BastaMasta/LumioV2_Hardware/Hardware/LumioV2-board-3d.png

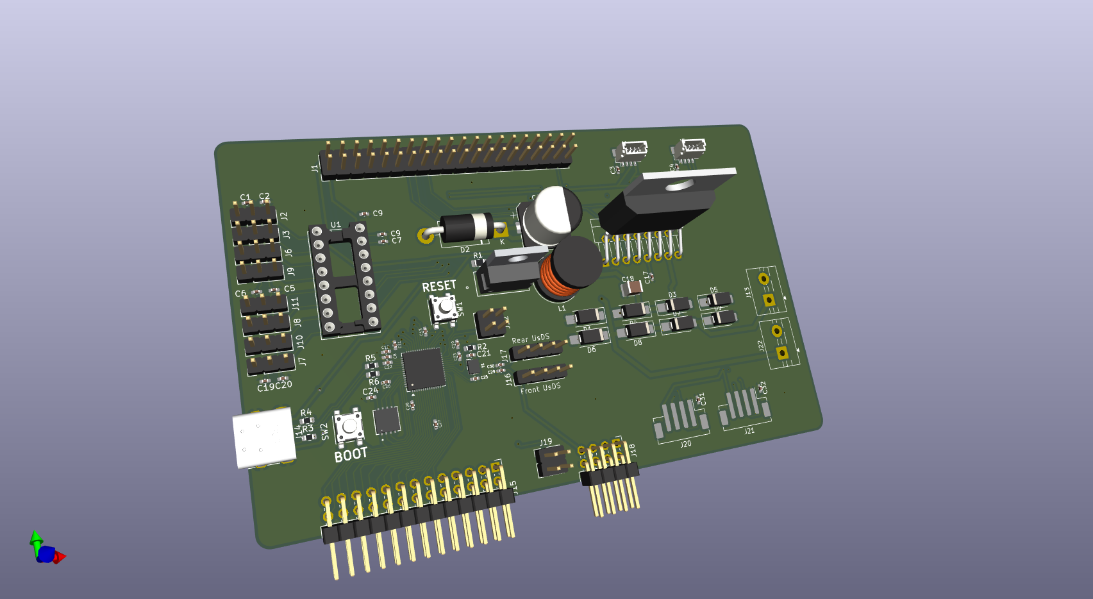
Hardware/LumioV2-board-3d.png
