BastaMasta/LumioV2_Hardware/README.md

# Lumio V2 Hardware

A repo containing all the hardware (shematic and PCB) files for the Lumio V2 Main Board
