BastaMasta/LumioV2_Hardware/Docs/SonyTech_Internship_FieldReport_TVA.pptx

🤖

INTERNSHIP REPORT

An 8-month internship report with SonyTech IT Company

Internship Field Report

Sameed Ahmed · 2VX22CB043

SonyTech IT Company · Aug 2025 – Apr 2026

VTU, Belagavi · CSE & Business Systems

## Slide 2

OVERVIEW

Internship At a Glance

35

Weeks

Aug 2025 – Apr 2026

5

PCB Revisions

V1 → Definitive V2

40+

Test Cases

All passing at close-out

4

Control Pathways

Sheets · IR · BT · WiFi

Project Timeline

Prototype
& Firmware

Onboarding
& EduTrack

PCB V1–V5
Design Arc

Lumio V2
Clean-Sheet

Handover
& Remote

Aug '25 Apr '26

## Slide 3

ORGANIZATION

SonyTech IT Company

SonyTech IT Company

Technology solutions firm specialising in software engineering, embedded systems, and educational technology.
Industry Mentor: Mr. Pranay M Mahendrakar
Location: Bengaluru, Karnataka

R.A.D.G.T.F Foundation

Educational non-profit commissioning the Lumio platform. Focused on innovative tools for classroom learning.
Defined requirements, reviewed prototypes, and guided technical priorities with emphasis on student engagement, safety, and classroom ease-of-deployment.

Academic Context Visvesvaraya Technological University, Belagavi · B.Tech CSE & Business Systems · 2025–2026 · Faculty Mentor: Mr. Rohit B Kaliwal

## Slide 4

THE PROJECT

What is Lumio?

An intelligent, open-hardware educational classroom robot — built from first principles.

Hardware

Custom 4-layer PCB (Lumio V2) with RP2040 co-processor, L298N motor driver, MCP3008 ADC, LM2577 boost converter, and full sensor array.

🔌

Firmware

HAL-abstracted multi-threaded Python stack — four concurrent control pathways, queue-arbitrated motor executor, display pipeline.

⚙️

On-Device AI

Vosk STT wake-word detection + Ollama (phi3:mini) LLM inference + Piper TTS — fully offline, no cloud dependency.

🧠

Google Sheets

Q&A engine and student progress reporting backend — teachers interact through a familiar spreadsheet interface.

📊

## Slide 5

HARDWARE

System Architecture

Lumio V2 PCB
4-layer, 115×73mm

Raspberry Pi 5
Primary Compute

DSI Display
Visual Output

40-pin ribbon

UART Interface

DSI Cable

Debug Power interface

RP2040
Co-Processor

DFRobot UPS
Battery-Backed

Pi Camera
(AI Vision — WIP)

L298N + SS34B
Motor Driver

MCP3008 SPI ADC
8-Channel Sensors

LM2577 Boost
5V → 12V Rail

## Slide 6

PCB DESIGN

PCB Journey: V1 → Definitive V2

V1

Pi Zero 2W
Chassis

Jumper-cable
prototype

V2–V5

CM5 Carrier
Exploration

Iterative
hardware arc

V2
Final

RPi 5 Platform
Clean-Sheet

DRC-clean
PCBA-ready

→

→

Key Design Decisions in Definitive V2

MCP3008 SPI ADC (8-ch) replacing ADS1115 — simpler sensor routing

SS34B Schottky freewheel diodes replacing 1N4148 — correct PWM flyback behaviour

LM2577 boost (5V→12V) with Vout = 1.23 × (1+R1/R2) design-from-equation

RP2040 (QFN-56) with W25Q64 SPI flash, 12MHz crystal, USB-C programming port

DSI display replacing I2C HAT — native RPi firmware framebuffer, no custom driver

Custom KiCad RPi 5 40-pin ribbon header symbol (Conn_02x20_Odd_Even)

## Slide 7

FIRMWARE

Firmware Architecture

Two-layer design: HAL (hardware abstraction) + RobotController (zero GPIO dependency)

LLM Pipeline

Motor Executor

Display Renderer

WiFi Server

Watchdog

Shared Command Queue (threading.Queue + threading.Event arbitration)

Hardware Abstraction Layer (HAL)
MotorHAL · SensorHAL · DisplayHAL

4 Control Pathways:

MockHAL (Test Doubles)
Unit tests · Integration tests · Off-hardware CI

📊 Google Sheets

🔴 Infrared

🔵 Bluetooth

🌐 WiFi Web Panel

v1.1.0 tagged release · All threads with explicit lifecycle management · No command starvation under concurrent load

## Slide 8

RP2040 SUBSYSTEM

RP2040 Co-Processor Subsystem

SPI Flash

W25Q64 on QSPI pins — program storage and runtime data. QSPI traces length-matched during PCB layout.

💾

12MHz Crystal

HC-49SMD with correctly calculated 33pF load capacitors (CL=20pF, each cap = 2×CL − stray = 35pF → 33pF std).

⏱️

USB-C Port

5.1kΩ CC resistors + 27Ω D+/D− impedance matching. BOOTSEL/RESET tactile switches for programming.

UART Bridge

Communicates with RPi 5 over UART using a lightweight JSON command protocol. Extends GPIO capacity.

🔌

📡

QFN-56 thermal pad requires GND via stitching · ERC resolved 18 warnings including floating ADC channels and missing no-connects

## Slide 9

AI INTEGRATION

On-Device AI Voice Pipeline

Fully offline — no cloud dependency. Runs as a dedicated thread alongside all system threads.

🎤

👂

🧠

🔊

→

→

→

Microphone
Input

Vosk STT
Wake-Word

Ollama
phi3:mini LLM

Piper TTS
Output

Continuous audio
capture

Offline speech-to-text
detection

Local LLM inference
on RPi 5

Text-to-speech
response

Zero Cloud Latency

Responses generated locally — classroom deployments with unreliable internet work seamlessly.

Student Q&A

Natural language questions answered semantically, not just keyword matching.

Privacy First

No audio leaves the device — compliant for classroom environments with minors.

## Slide 10

TESTING & QA

Testing & Quality Assurance

Mock HAL Injection

MockMotorHAL, MockSensorHAL — complete unit tests with zero hardware dependency. Tests run on any machine.

40+

integration
test cases

all passing
at close-out

Concurrent Testing

threading.Barrier for synchronised multi-thread test scenarios. Time-frozen assertions via unittest.mock.patch.

Integration Scenarios

Full command pipeline, obstacle abort, emergency stop under all pathways, network outage recovery.

Systematic Design

Equivalence partitioning + boundary value analysis for parser test cases. Severity/effort matrix for debt triage.

HAL abstraction was the single most impactful architectural decision — it made the entire test suite possible.

## Slide 11

CROSS-TEAM WORK

Cross-Team Software Contributions

Weeks 2–3: assisted another SonyTech product team with critical bug fixes in a Flask/SQLite web application (details kept proprietary).

Concurrency Bug Fix

Traced and resolved a Flask-SocketIO race condition under concurrent client load. Refactored session state to a thread-safe Queue-based architecture, maintaining full backward compatibility.

🔒

SQL Data Integrity

Fixed a silent data truncation bug in a report export endpoint — no exception raised, identified through careful data comparison. Used SQLite PRAGMA integrity_check during debugging.

🗄️

Dependency Management

Resolved a transitive Python dependency conflict in requirements. Introduced pip-compile for deterministic builds and transitive dependency pinning.

📦

Structured Logging

Added rotating-file logging across the codebase with structured log levels — replacing ad-hoc print statements and enabling production-grade observability.

📋

Left the codebase in measurably better condition than found — a principle reinforced throughout the internship.

## Slide 12

SKILLS GAINED

Technical Skills Developed

Embedded Hardware

KiCad schematic, PCB layout, DRC, Gerber, JLCPCB PCBA

Boost converter design from voltage equation

Motor flyback & Schottky diode selection

Crystal load capacitor calculation

Staged board bring-up with pass/fail criteria

Professional Skills:

Firmware & Software

HAL abstraction pattern in Python

Multi-threaded concurrent programming

Custom I2C/SPI sensor drivers from datasheets

Raw-to-SI unit conversion

Semantic versioning & Git conventions

Testing & QA

Dependency-injected mock objects

threading.Barrier for concurrent tests

Equivalence partitioning & BVA

Technical debt severity/effort triage

40+ integration test scenarios

Client communication

Scope negotiation

Handover documentation

Remote collaboration

Code review culture

## Slide 13

DELIVERABLES

Deliverables Produced

Lumio Firmware v1.1.0

Tagged & Archived

📦

PCB V1–V5 (Prototype Arc)

V3 validated production

🔧

Lumio V2 PCB (Definitive)

DRC-clean, PCBA-ready

🖥️

Unit & Integration Tests

40+ cases, all passing

Google Sheets Q&A Engine

Delivered

GIF Display Pipeline

10 assets, state-synced

✅

📊

🎞️

4 Control Pathways

Sheets/IR/BT/WiFi concurrent

🎮

Project Handover Document

Architecture + bring-up guide

📄

EduTrack Bug Fixes

SocketIO, SQL, deps, logging

🐛

## Slide 14

CHALLENGES

Challenges & How They Were Overcome

⚠ Framebuffer Driver Conflicts (I2C HAT)

Migrated to DSI display — native RPi firmware support, zero custom driver config required.

⚠ PWM Flyback Destroying 1N4148 Diodes

Replaced with SS34B Schottky (3A, SMA, 0.35V Vf) — correct reverse-recovery behaviour at PWM frequencies.

⚠ HC-49SMD Crystal Misplacement

Discovered load caps connect pin-to-GND only (no GND pins on body) — corrected schematic before layout.

⚠ CM5 Custom-Carrier Complexity

Pivoted to RPi 5 + DFRobot UPS — eliminated custom BMS circuit, accelerated bring-up significantly.

⚠ Concurrent Thread Race Conditions

threading.Event + Queue architecture with explicit lifecycle — tested with threading.Barrier synchronisation.

⚠ Silent SQL Data Truncation

Identified via data comparison + PRAGMA integrity_check; no exception was raised by the original bug.

## Slide 15

Conclusion

35 weeks · End-to-end ownership · Hardware to firmware to handover

Delivered a production-grade educational robot — prototype through five PCB revisions to a definitive, PCBA-ready V2 board

Built a fully testable, HAL-abstracted firmware stack released at v1.1.0 with 40+ passing test cases

Integrated on-device AI (Vosk + Ollama + Piper) for offline natural language Q&A — no cloud dependency

Contributed critical bug fixes to a second proprietary product, leaving the codebase in better condition than found

Developed professional competencies: client communication, scope negotiation, handover documentation, remote collaboration

"This internship confirmed my intent to pursue a career that bridges hardware and software — systems where firmware, PCB design, and product thinking are inseparable disciplines."

## Slide 16

End of Report

Sameed Ahmed

B.Tech CSE & Business Systems · VTU Belagavi

Intern · SonyTech IT Company · Lumio Project

GitHub: github.com/BastaMasta/LumioV2

Queries & Clarifications

🤖
