BastaMasta/LumioV2_Hardware/Docs/Sameed_Internship_Report.docx

INTERNSHIP REPORT

Lumio Educational Robot Platform

Intern Name | : Sameed
Organization | : SonyTech IT Company
Client / Sponsor | : R.A.D.G.T.F Foundation
Project | : Lumio — Classroom Robot Platform
Internship Period | : August 11, 2025 – Present (Core: Feb 26, 2026)
Duration | : 28.5 Weeks (Core) + Ongoing Remote Phase
Report Date | : April 2026

Visvesvaraya Technological University, Belagavi – 590 018

# Certificate

This is to certify that Mr. Sameed Ahmed has successfully completed his internship at SonyTech IT Company from August 11, 2025 to April 2, 2026, a period of approximately 35 weeks.

During the internship, he was assigned to the Lumio Educational Robot Platform project, commissioned by the R.A.D.G.T.F Foundation. He worked independently and as part of the development team, demonstrating strong initiative and technical proficiency across embedded systems firmware, PCB design, software architecture, and quality assurance.

His contributions include the complete design and delivery of the Lumio robot platform — from jumper-cable prototype to a multi-revision custom PCB (V1 through V5), along with a production-ready HAL-based firmware stack, a comprehensive test suite, four independent control pathways, and a real-time display and Q&A subsystem. The project was handed over with full documentation and a versioned v1.1.0 release.

We wish him the best in his academic and professional pursuits.

____________________________ Supervisor / Manager SonyTech IT Company | ____________________________ Intern Sameed

Place & Date: Bengaluru, April 2026

# Acknowledgements

I would like to express my sincere gratitude to SonyTech IT Company for providing me with the opportunity to contribute to a meaningful, technically challenging project over the course of this internship. The experience of working in a professional software and embedded systems environment has been invaluable to my development as an engineer.

I am deeply grateful to my supervisors and colleagues at SonyTech for their consistent guidance, constructive feedback, and patience during the early phases of the project. Their support in navigating both technical and professional challenges helped me grow significantly.

I extend my thanks to the R.A.D.G.T.F Foundation for the trust they placed in our team by commissioning the Lumio platform, and for their active participation in requirements discussions, prototype reviews, and sign-off sessions. Working directly with a client with a real educational mission was a formative experience that I will carry forward throughout my career.

I also thank Visvesvaraya Technological University for encouraging industry-integrated learning that bridges academic knowledge with practical engineering — an approach exemplified by this internship.

Finally, I thank my family and peers for their encouragement throughout the duration of this programme.

Sameed

April 2026

# Index of Contents

i | Cover Page
ii | Certificate
iii | Acknowledgements
iv | Index of Contents
v | About the Organization
vi | Objectives of Internship
vii | Learning Experiences
viii | Learning Outcomes
ix | Conclusion / Summary
x | Attachments

# About the Organization

## SonyTech IT Company

SonyTech IT Company is a technology solutions firm specialising in software engineering, embedded systems development, and educational technology. The company operates across multiple domains, providing both in-house software products and client-commissioned engineering services. Internally, SonyTech follows professional software development practices including structured version control, code review workflows, and documented software delivery processes.

The company's engineering teams work on a range of products — from web-based educational dashboards (such as the EduTrack platform) to fully custom embedded robotics systems. SonyTech's commitment to quality engineering is reflected in its adoption of test-driven development, systematic dependency management, and structured project handover procedures.

## The R.A.D.G.T.F Foundation

The R.A.D.G.T.F Foundation is an educational non-profit organisation focused on developing innovative tools for classroom learning. As the commissioning client for the Lumio project, the Foundation worked closely with SonyTech to define requirements, review prototypes, and guide the direction of the educational robot platform. Their emphasis on student engagement, safety, and ease of classroom deployment directly shaped the technical and UX priorities of the Lumio system.

## The Lumio Project

Lumio is an educational classroom robot platform designed to serve as an interactive, programmable learning companion in school environments. The final platform uses a full-size Raspberry Pi 5 — chosen for native UPS support via the DFRobot UPS Module for Raspberry Pi 5, ready HAT access, and straightforward bring-up — connected to the custom Lumio V2 PCB via a 40-pin GPIO extension ribbon cable that delivers all SPI, I2C, UART, PWM, and GPIO signals across the ribbon. The platform integrates motor drivers, sensor arrays, a DSI display, an RP2040 co-processor, and an optional AI voice interface, with a multi-layered software stack supporting four independent control pathways: Google Sheets command interface, Infrared remote, Bluetooth, and WiFi web panel. On-system power is managed by the DFRobot UPS Module for Raspberry Pi 5, providing battery-backed operation without additional power circuitry on the Lumio board itself.

The project was commissioned by the R.A.D.G.T.F Foundation and executed entirely by the intern over the 28.5-week internship period, spanning prototype construction, PCB design through five hardware revisions, firmware development, test suite construction, and final handover.

# Objectives of Internship

## Primary Technical Objectives

- Design and deliver a functional classroom robot platform (Lumio) from first principles, covering hardware prototyping, custom PCB design, and production firmware.
- Develop a multi-threaded embedded software architecture supporting simultaneous control from four independent pathways: Google Sheets, Infrared, Bluetooth, and WiFi.
- Design and fabricate a custom PCB through iterative hardware revisions (V1–V5) using KiCad and JLCPCB PCBA services.
- Implement a Hardware Abstraction Layer (HAL) to decouple firmware business logic from GPIO-specific calls, enabling off-hardware unit and integration testing.
- Build a comprehensive automated test suite: unit tests using mock HAL classes and 40+ integration tests covering full command pipeline scenarios.
- Integrate a display pipeline for animated GIF playback on an ILI9486 TFT screen, synchronised with robot state transitions.
- Implement a Q&A engine and student progress reporting system connected to a Google Sheets backend.

## Secondary & Cross-Team Objectives

- Contribute to the EduTrack Dashboard codebase during weeks 2–3, including debugging a Flask-SocketIO race condition, fixing SQL query bugs, and implementing rotating-file logging.
- Gain experience in client-facing engineering — presenting prototypes, negotiating scope, and communicating technical decisions to non-technical stakeholders.
- Develop professional documentation skills: README files, ASCII wiring diagrams, firmware interface specifications, and a final project handover document.

## Personal Learning Objectives

- Apply embedded systems design principles in a production context — moving beyond breadboard modules to custom bare-chip PCB design.
- Strengthen test-driven development practices for concurrent, hardware-dependent software.
- Build familiarity with the full hardware production workflow: schematic capture, PCB layout, DRC, BOM preparation, JLCPCB PCBA ordering, and board bring-up.
- Develop the habit of documenting systems for the reader's first day rather than as a knowledge dump.

# Learning Experiences

## Phase 1 — Onboarding & Cross-Team Contribution (Weeks 1–3)

The internship commenced with a structured onboarding week that introduced the SonyTech project ecosystem, internal Git conventions, and the team's embedded systems architecture — including an MQTT/Redis integration layer, RS485 bus arbitration, and Raspberry Pi-based hardware nodes. Configuring remote SSH access to headless Pi hardware and validating GPIO and SPI interface availability provided an early hands-on introduction to the embedded development environment.

In weeks 2 and 3, I was assigned to assist the EduTrack Dashboard team with a critical bug: a Flask-SocketIO race condition causing intermittent session corruption under concurrent client load. Reproducing the condition, tracing it to unprotected global state, and refactoring session management to a thread-safe Queue-based architecture was a demanding and rewarding early task. Additional work included fixing a silent SQL data truncation bug, resolving a transitive Flask/Werkzeug dependency conflict, and implementing structured rotating-file logging across the codebase. These weeks established a strong foundation in debugging concurrent Python systems and professional software maintenance practices.

## Phase 2 — Lumio Project Assignment & Software Architecture (Weeks 3–6)

Upon formal assignment to the Lumio project, I reviewed the R.A.D.G.T.F Foundation's educational brief and attended a stakeholder planning session to define system requirements. Translating educational goals into concrete technical specifications — GPIO pin assignments, hardware component choices, control pathway architecture — was a significant exercise in requirements engineering. The initial hardware stack proposed to and signed off by the Foundation used a Raspberry Pi Zero 2W as the robot's physical chassis compute board (small form factor, low cost, sufficient for client demonstration), while firmware development and testing ran on a Raspberry Pi 5 — the platform that would ultimately become the final product compute board.

The software architecture was designed from the outset with concurrency in mind: five threads communicating via threading.Event and Queue objects, ensuring that the Sheets command poller, motor executor, display pipeline, WiFi server, and watchdog timer could run concurrently without race conditions. The GIF display pipeline using PIL ImageSequence.Iterator, luma.lcd SPI canvas management, and frame caching provided a technically rich challenge, including discovering that GIF frame delays are stored in centiseconds — not milliseconds — a subtle detail that caused incorrect animation speeds until traced and corrected.

Building the WiFi control interface with Flask-SocketIO — including a real-time bidirectional status channel, emergency stop mechanism that bypasses the command queue, and a live 2D position map in HTML canvas — was a highlight of this phase. The experience deepened my understanding of asynchronous web transport and the importance of eventlet as a worker for reliable WebSocket operation.

## Phase 3 — Prototype Completion & PCB Design (Weeks 7–10)

After eight weeks of software and hardware prototyping, the jumper-cable Lumio prototype was presented to SonyTech and the R.A.D.G.T.F Foundation for sign-off. The experience of framing a prototype's physical limitations as intentional rapid validation — and having that framing accepted professionally — was an important lesson in client communication.

PCB design began in KiCad with schematic capture for V1: placing and wiring the Pi Zero 2W (the client-approved chassis platform), L298N dual H-bridge motor driver, ILI9486 display, RCWL-1601 ultrasonic sensor, and HC-05 Bluetooth module. Creating custom footprints for non-standard components, routing differential signal pairs, and generating JLCPCB-compliant Gerber and BOM files were all new skills acquired during this phase. The V1 board was ordered and the waiting period was used productively to begin the HAL firmware refactor — with all firmware continuing to be developed and validated on the RPi 5 development platform.

## Phase 4 — HAL Firmware & Test Suite (Weeks 11–14)

With the V1 PCB in transit, I designed and implemented the Hardware Abstraction Layer (hal.py): a MotorHAL and SensorHAL class pair wrapping all RPi.GPIO calls, constructed using dependency injection so that MockMotorHAL and MockSensorHAL could be substituted in test environments without hardware. The MockMotorHAL recorded every GPIO call with timestamps as (pin, value, timestamp) tuples, enabling assertion-based unit tests that verified pin and value sequences.

The unit test suite (test_motor_hal.py, test_command_pipeline.py) used unittest.mock.patch('time.time') to freeze time and threading.Barrier to synchronise concurrent test threads. Equivalence partitioning and boundary value analysis were applied to systematically generate edge-case command parser tests. The integration test suite grew to 40+ cases covering multi-command sequences, obstacle abort mid-movement, emergency stop under all four pathways, and reconnect-after-outage scenarios.

## Phase 5 — PCB Revisions V2–V5 & Hardware Iteration (Weeks 15–22)

V1 board bring-up confirmed the Pi Zero 2W's processing margin was insufficient for the Q&A engine and voice pipeline workload — a limitation that had been masked during development because all firmware was running on the RPi 5. This drove a PCB architecture pivot: V2 through V5 entered a CM5 custom-carrier exploration track, targeting the Compute Module 5 as the planned production compute platform for its improved PCIe 3.0, USB 3.0, and dual MIPI CSI/DSI interfaces. This track introduced significantly more complex PCB challenges including 200-pin Hirose DF40C connector placement at 0.4mm pitch, differential pair length-matching, USB 3.0 trace geometry, and MIPI CSI-2 signal integrity across four-layer stackups. Additional revisions (V3, V4, V5) addressed connector footprint corrections, power supply robustness, and sensor placement.

A critical addition during this phase was the L298N current sense circuit: a dual-path architecture combining an LM393 hardware comparator for hard overcurrent cutoff (protecting motors and the PCB) and an RC-filtered ADC path into an ADS1115 for stall detection and torque monitoring. This design was intentionally MCU-agnostic — the hardware comparator acts unconditionally, independent of firmware state. Designing a safety-first circuit with hardware-enforced limits alongside software monitoring was one of the most technically rewarding experiences of the internship.

Sensor drivers for the ADS1115 ADC and ICM-42688-P IMU were implemented from scratch against their datasheets on the RPi 5 — the consistent development platform throughout — including proper I2C register addressing, raw-to-SI unit conversion, and interrupt configuration. Offline voice command integration using Vosk STT, a wake-word gate, Ollama (phi3:mini) for LLM inference, and Piper TTS was completed as a third thread alongside the Sheets poller and display threads, and validated fully on the RPi 5.

## Phase 6 — V4 Bring-Up, Q&A Engine & Final Milestones (Weeks 22–27)

V3 board bring-up followed a staged verification procedure: power rails first (5V, 3.3V, 1.8V), I2C bus scan, SPI device verification, MIPI display initialisation, and final full firmware smoke test. V3 became the validated production prototype on the CM5 carrier track. The Q&A engine was extended with image analysis capabilities (foundation-level), and the student progress reporting system was connected to the Google Sheets backend with structured logging of interaction events. All software, however, remained validated on the RPi 5 as the primary development platform — the CM5 carrier boards served as hardware verification targets.

Bluetooth HID implementation for the keyboard control pathway required resolving a BlueZ D-Bus API version conflict — a debugging exercise that spanned multiple days and involved reading D-Bus introspection XML to identify the API version mismatch. The experience was a formative lesson in working with complex, underdocumented system APIs.

## Phase 7 — Project Closure & Handover (Weeks 28–29)

The final weeks were dedicated to software audit, documentation, and handover. A severity/effort matrix was used to triage remaining technical debt, separating high-severity/low-effort items addressed immediately from items logged as known issues for the next development cycle. The project handover document covered architecture overview, V5 bring-up procedure, firmware test suite guide, and known issues — written with the principle of addressing what a new engineer would need in their first week rather than providing an exhaustive knowledge dump.

The v1.1.0 release was tagged after a pre-tag code review that searched for TODO, FIXME, and debug print statements. V5 boards (the final CM5 carrier revision) arrived from JLCPCB on February 24, 2026 — power-rail bring-up passed successfully (5V, 3.3V, 1.8V all correct) — with full CM5 boot and peripheral bring-up deferred, as the architecture decision to return to the RPi 5 platform was already underway.

## Phase 8 — Lumio V2 Clean-Sheet PCB Design (Weeks 30–35, Remote)

Following the internship break, work resumed in March 2026 under a remote working arrangement agreed with SonyTech management, with progress tracked via daily written updates and weekly video check-ins. Rather than continuing to iterate on the V1–V5 CM5-carrier exploration track, the decision was made to consolidate all hardware learnings into a single, definitive Lumio V2 PCB — a clean-sheet four-layer design (~115×73mm) on a full-size Raspberry Pi 5 platform. The RPi 5 was chosen over the CM5 for three concrete reasons: native on-system UPS support via the DFRobot UPS Module for Raspberry Pi 5 (eliminating the need for a custom battery management circuit on the Lumio board), ready access to HAT peripherals, and significantly simpler bring-up without a custom carrier. The Lumio V2 board connects to the RPi 5 via a standard 40-pin GPIO extension ribbon cable, delivering all SPI, I2C, UART, PWM, and GPIO signals across the ribbon.

The V2 architecture resolved several tradeoffs made under earlier time pressure. The MCP3008-I/SL (SOIC-16) replaced the ADS1115 as the ADC choice — offering 8 channels in a single chip via SPI, simplifying the sensor header routing considerably. The LM2577T-ADJ boost converter circuit was designed from the voltage equation up (Vout = 1.23 × (1 + R1/R2) = 12V), with a 100µH inductor, 1N5821 Schottky rectifier, and a 680µF polymer SMD output filter. The L298N freewheel diodes were upgraded from 1N4148 (300mA, too slow for PWM flyback) to SS34B Schottky diodes (3A, SMA, ~0.35V forward voltage), eliminating reverse-recovery losses at PWM switching frequencies — a direct application of motor flyback theory learned during the V1–V4 arc.

The RP2040 co-processor subsystem (QFN-56) was placed with its full support circuit: W25Q64 SPI flash on QSPI pins, a 12MHz HC-49SMD crystal with correctly calculated 33pF load capacitors (CL=20pF → each cap = 2×20 − 5pF stray = 35pF → 33pF nearest standard), a USB-C programming port with 5.1kΩ CC resistors and 27Ω D+/D− impedance matching, and BOOTSEL/RESET tactile switches. A non-obvious discovery during this phase: the HC-49SMD is a 2-pin crystal package — load capacitors connect from each pin to GND only, with no GND pins on the crystal body — requiring a schematic correction after initial incorrect placement.

The sensor and expansion infrastructure placed 8 analog sensor headers (3-pin: VCC/Signal/GND, each with 100nF bypass), 4 I2C expansion ports (2 QWIIC JST-SH + 2 JST-PH), and front/rear HC-SR04 ultrasonic headers. The Raspberry Pi 5 40-pin GPIO ribbon extension header required building a custom KiCad symbol (Conn_02x20_Odd_Even) with all 40 pins correctly typed (BiDi for GPIO, Power output for the 3V3/5V rails driven from the RPi 5 via the ribbon, Power input for GND) — no verified symbol for the RPi 5 standard header existed in the KiCad libraries.

ERC resolution addressed 18 warnings including missing no-connects on unused GPIO pins, floating ADC channels, and power flag placement. The bulk footprint assignment pass — performed via KiCad's Edit Symbol Fields bulk editor rather than opening each component individually — covered all capacitors, the MCP3008, RP2040, LM2577, SS34B diodes, and the DSI display connector (replacing the earlier I2C HAT approach, which had caused framebuffer driver difficulties). The display migration to DSI was confirmed as the correct choice for a classroom-deployed product: natively supported by Raspberry Pi firmware with no custom driver configuration required.

PCB layout on a 2-layer stackup (F.Cu/In1.Cu/In2.Cu/B.Cu) required careful routing priority: 2mm traces for the 12V motor supply, 1mm for 5V, 0.5mm for 3.3V signal. High-connectivity ICs were placed first. The RP2040's QFN-56 thermal pad required GND via stitching for heat dissipation. USB differential pairs were routed with 27Ω series resistors and kept short; QSPI flash traces were length-matched. GND copper pours were applied to all layers. The board reached DRC-clean status and was confirmed ready for JLCPCB PCBA submission pending final BOM LCSC part number assignment.

# Learning Outcomes

## Technical Competencies Gained

Embedded Systems & Hardware Design

- Designed and fabricated five PCB revisions (V1–V5) using KiCad: V1 around a Pi Zero 2W chassis, V2–V5 as a CM5 custom-carrier exploration track targeting a production upgrade, and ultimately a definitive Lumio V2 clean-sheet board designed for the Raspberry Pi 5 as the final platform — informed by the full arc of learnings across all prior revisions.
- Designed the definitive Lumio V2 PCB from scratch (clean-sheet, 4-layer, ~115×73mm): integrating RP2040 (QFN-56), MCP3008 ADC (SOIC-16), LM2577 boost converter, L298N with SS34B Schottky freewheel diodes, DSI display connector, 8 sensor headers, 4 I2C expansion ports, and USB-C RP2040 programming port — reaching DRC-clean PCB layout ready for JLCPCB PCBA.
- Mastered KiCad schematic capture, PCB layout, DRC, Gerber generation, BOM preparation, and JLCPCB PCBA ordering workflow end-to-end.
- Implemented a safety-critical current sense circuit: hardware comparator (LM393) for unconditional overcurrent cutoff, and RC-filtered ADC path (ADS1115) for software-level stall detection and torque monitoring.
- Developed custom I2C/SPI sensor drivers for ADS1115 and ICM-42688-P from datasheets, including register-level configuration and raw-to-SI unit conversion.
- Executed staged board bring-up procedures with explicit pass/fail criteria per stage: power rail verification, I2C bus scan, SPI device handshake, display initialisation, and full firmware smoke test.

Firmware & Software Architecture

- Designed and implemented a two-layer firmware architecture: a thin HAL encapsulating all hardware calls, and a RobotController business logic layer with zero direct GPIO dependencies — enabling complete off-hardware testing.
- Built a concurrent multi-threaded Python application with five threads (Sheets poller, motor executor, display renderer, WiFi server, watchdog) communicating via threading.Event and Queue, with explicit lifecycle management.
- Implemented four independent robot control pathways (Google Sheets, Infrared, Bluetooth, WiFi) arbitrated through a shared Queue-based executor with no command starvation under concurrent load.
- Integrated an offline AI voice pipeline: Vosk STT wake-word detection, Ollama (phi3:mini) LLM inference, and Piper TTS — running as a dedicated thread alongside existing system threads.

Testing & Quality Assurance

- Built a complete unit test suite using dependency-injected mock HAL classes (MockMotorHAL, MockSensorHAL), time-frozen assertions via unittest.mock.patch, and threading.Barrier for concurrent test synchronisation.
- Wrote 40+ integration tests covering full command pipeline scenarios, obstacle abort, emergency stop under all pathways, and network outage recovery.
- Applied equivalence partitioning and boundary value analysis for systematic parser test case design.
- Used a severity/effort matrix for technical debt triage at project close-out.

## Professional Competencies Gained

- Client communication and requirements negotiation — translating educational briefs into technical specifications, presenting prototypes to non-technical stakeholders, and managing scope.
- Documentation for handover — writing architecture overviews, firmware interface contracts, bring-up procedures, and project close-out checklists written for the reader's first day, not as knowledge dumps.
- Dependency management — resolving transitive Python dependency conflicts, understanding version pinning, and using pip-compile for deterministic builds.
- Professional Git hygiene — semantic versioning, pre-tag code review for debug artifacts, and structured commit conventions.
- Collaborative software maintenance — working within an existing codebase (EduTrack), tracing and fixing non-trivial concurrent bugs, and leaving the codebase in better condition than found.

## Deliverables Produced

Deliverable | Status
Lumio Firmware (v1.1.0) | Tagged and archived — HAL, test suite, bring-up scripts, voice pipeline
PCB Designs V1–V5 (Prototype Arc) | KiCad projects, Gerbers, BOM files — V3 validated production prototype; V5 power-rail bring-up passed
Lumio V2 PCB (Definitive Design) | Clean-sheet four-layer board (~115×73mm), KiCad 9.0, ERC-clean, DRC-clean, PCBA-ready pending BOM finalisation
Unit & Integration Test Suite | 40+ test cases — all passing at close-out
Google Sheets Q&A Engine | Delivered with student progress reporting
GIF Display Pipeline | 10 GIF assets, atomic state-synchronised switching
Four Control Pathways | Sheets, IR, BT, WiFi — concurrent, queue-arbitrated
Project Handover Document | Architecture, known issues, V5 bring-up guide, test suite guide
EduTrack Bug Fixes | SocketIO race condition, SQL bug, dependency conflict, logging

# Conclusion / Summary

This internship represented an intensive, end-to-end engineering experience spanning the full product development lifecycle — from client requirements gathering and rapid prototyping to custom PCB fabrication, production firmware delivery, formal project handover, and a continuing remote design phase. Over a core period of 28.5 weeks at SonyTech IT Company — followed by an ongoing remote work phase from March 2026 — I was the sole engineer responsible for the Lumio educational robot platform, commissioned by the R.A.D.G.T.F Foundation.

The most significant technical growth came from three interlocking threads: the hardware design progression from a Pi Zero 2W jumper-cable prototype through five PCB revisions on a CM5 custom-carrier track, and finally into a clean-sheet definitive V2 board returning to the Raspberry Pi 5 as the final platform; the software architecture progression from a monolithic script to a HAL-abstracted, multi-threaded, fully testable firmware stack — developed throughout on an RPi 5 — with a cleanly versioned v1.1.0 release; and the PCB design methodology progression from module-carrier boards to a JLCPCB PCBA-targeted, four-layer board designed with deliberate component selection, trace-width discipline, and ERC/DRC verification from the outset.

The remote V2 design phase (Weeks 30–35) distilled every lesson from the prototype arc into a single board — replacing ADS1115 with MCP3008 for 8-channel SPI simplicity, upgrading freewheel diodes from 1N4148 to SS34B Schottky for correct PWM flyback behaviour, properly calculating crystal load capacitors, building a custom KiCad RPi 5 ribbon header symbol, migrating the display interface to DSI for reliable framebuffer support, and landing on the RPi 5 + DFRobot UPS module platform for clean on-system power without a custom BMS. The discipline of working remotely — maintaining clear daily written updates and structured weekly check-ins — was itself a professional skill developed during this phase.

Beyond technical skills, the internship cultivated professional competencies difficult to acquire in an academic setting — client communication, scope negotiation, hardware bring-up discipline, remote collaboration, and the art of writing documentation for the reader's first day. Working across two codebases (EduTrack and Lumio) in a real team environment reinforced the importance of code review culture, deterministic dependency management, and leaving code better than you found it.

At the time of writing, the Lumio V2 PCB is DRC-clean and pending final BOM LCSC part number assignment before JLCPCB PCBA submission. The v1.1.0 firmware is archived and tagged. The project is positioned for continued development with a clear architecture, a comprehensive test suite as a safety net, and a handover document designed to bring a new engineer up to speed quickly.

This internship confirmed my intent to pursue a career that bridges hardware and software — working on systems where firmware, PCB design, and product thinking are inseparable disciplines. The experience at SonyTech has been foundational to that goal.

Sameed

April 2026

# Attachments

The following supplementary documents and artefacts are available to accompany this report:

## Attachment A — Daily Internship Diary

The full daily diary (SonyTech-Sameed-Daily_Diary.docx) covers August 11, 2025 through April 2, 2026, documenting day-by-day activities, technical challenges encountered, and knowledge gained across all 29 weeks of the internship.

## Attachment B — Hardware Artefacts

- KiCad project files for PCB V1 through V5 (schematic, layout, Gerbers, BOM) — prototype arc
- KiCad 9.0 project for Lumio V2 definitive PCB (schematic, ERC-clean, DRC-clean PCB layout, BOM pending LCSC assignment)
- JLCPCB order documentation for V1, V2, V3, and V5 fabrication runs
- GPIO pin allocation spreadsheet and wiring diagrams for the jumper-cable prototype

## Attachment C — Software Repository

## Linked at: https://github.com/BastaMasta/LumioV2

- Lumio firmware repository — tagged at v1.0.0 and v1.1.0 — containing main.py, hal.py, all control pathway modules, voice integration, display pipeline, test suite, and bring-up scripts

## Attachment D — Documentation

- Project handover document — architecture overview, known issues, V5 bring-up procedure, test suite guide
- Project README (v1.1.0) — setup instructions, hotspot configuration guide, control pathway documentation, ASCII wiring diagrams

Attachments are available upon request from SonyTech IT Company or the intern directly.
