BastaMasta/LumioV2_Hardware/Docs/LumioV2_Presentation.pptx

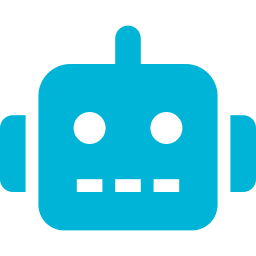
[picture p3: figure]

Lumio

An Intelligent Educational Classroom Robot Platform

Sameed Ahmed • 2VX22CB043
B.Tech – Computer Science and Business Systems
Visvesvaraya Technological University, Belagavi

SonyTech IT Company

R.A.D.G.T.F Foundation

2025–2026

## Slide 2

THE PROBLEM

Why do existing educational robots fall short?

Closed & Proprietary

Locked hardware and software prevent schools from extending or understanding what runs on them.

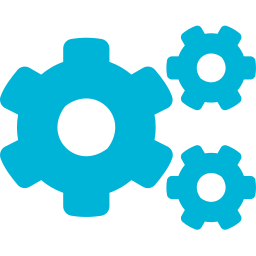
[picture p4: figure]

No Real AI

Existing kits lack modern AI: no on-device LLM, no vision, no natural language — just scripted commands.

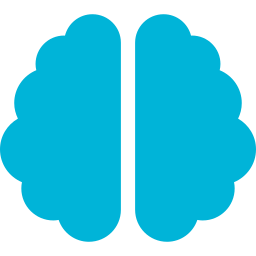
[picture p5: figure]

Cloud Dependent

Most AI features require internet connectivity — unreliable in real classrooms and unacceptable for data privacy.

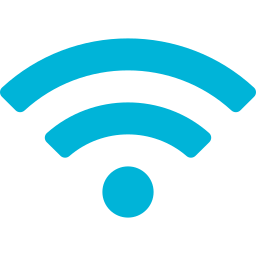
[picture p6: figure]

Lumio addresses all three — open hardware, embedded AI, fully offline.

## Slide 3

LUMIO AT A GLANCE

Three integrated layers — hardware, firmware, software

Raspberry Pi 5 — Debian Linux

Multi-threaded Python: voice interaction, LLM inference (Ollama phi3:mini), Piper TTS, wireless control, AI vision (in progress)

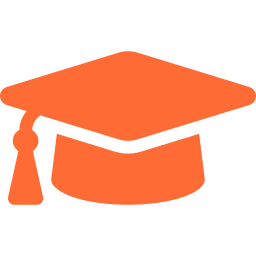
[picture p7: figure]

APPLICATION LAYER

RP2040 — MicroPython Firmware

GPIO expansion, ADC telemetry, display management. JSON command protocol over UART with RPi 5.

CO-PROCESSOR LAYER

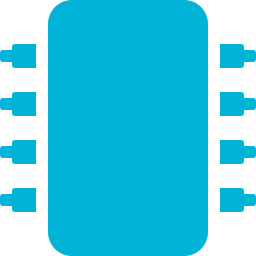
[picture p8: figure]

Lumio V2 PCB — KiCad 9.0

4-layer custom PCB: LM2577 boost, L298N motor driver, MCP3008 ADC, 8× sensor headers, QWIIC I2C, HC-SR04 ports.

HARDWARE LAYER

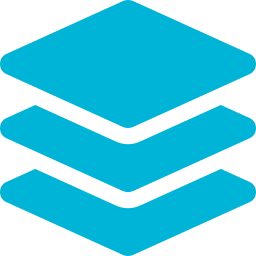
[picture p9: figure]

## Slide 4

HARDWARE ARCHITECTURE

Lumio V2 PCB — 4-layer, 115mm × 73mm, JLCPCB PCBA

Power Management

LM2577 boost: 5V → 12V
DFRobot UPS powers RPi 5
3 voltage domains: 3V3, 5V, 12V

Motor Control

L298N H-bridge (dual channel)
SS34B freewheel diodes
PWM from RPi 5 GPIO ribbon

Analog Sensing

MCP3008 8-ch 10-bit SPI ADC
8× 3-pin sensor headers
100nF bypass on each VCC

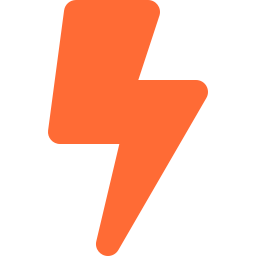
[picture p10: figure]
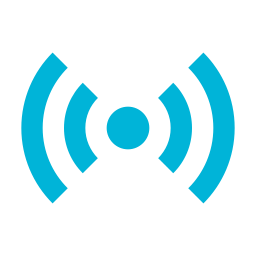
[picture p11: figure]

RP2040 Sub-system

QFN-56 co-processor
W25Q64 8MB SPI flash
12MHz HC-49SMD crystal

Connectivity

4× I2C ports (QWIIC + JST-PH)
2× HC-SR04 ultrasonic
40-pin GPIO ribbon to RPi 5

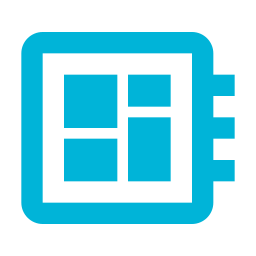
[picture p12: figure]

Display / Vision

DSI display (native RPi FW)
Replaced I2C HAT (V1)
CSI camera for AI vision

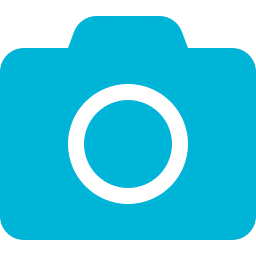
[picture p13: figure]

## Slide 5

RP2040 CO-PROCESSOR

GPIO expansion + telemetry + field-programmable via USB

Key Components

RP2040 QFN-56 • Dual Cortex-M0+ @ 133MHz

W25Q64 SPI Flash • 8MB program storage (QSPI)

12MHz HC-49SMD crystal • 33pF load caps

USB-C + 5.1kΩ CC resistors • BOOTSEL mode

27Ω D+/D– impedance matching • USB 1.1

SW1 BOOTSEL + SW2 RESET tactile switches

1µF + 100nF decoupling on all power pins

UART JSON Protocol

RPi 5 → RP2040:
{"action": "set", "pin": 5, "value": 1}
{"action": "adc_read", "channel": 3}
RP2040 → RPi 5:
{"status": "ok", "value": 712}

Why MicroPython?

Field-programmable via Thonny + USB mass storage boot — no cross-compilation toolchain needed. Non-specialist staff can update firmware in the classroom without removing the board.

## Slide 6

AI SOFTWARE STACK

100% offline AI — no cloud dependency

USB Mic

PyAudio
16kHz mono

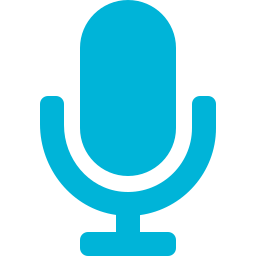
[picture p14: figure]

Wake Word

Lightweight
keyword gate

Vosk STT

Offline ASR
ARM-optimised

Ollama LLM

phi3:mini
3.8B params

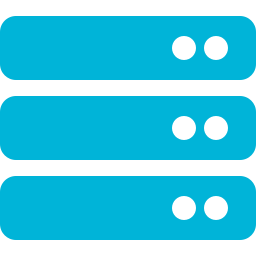
[picture p15: figure]

Piper TTS

Neural TTS
no network

Multi-threaded Python Architecture

VoiceCommandListener

Wake word → Vosk → Ollama → Piper pipeline running on its own daemon thread.

MotorControlThread

Translates high-level directives (forward/turn/stop) into PWM GPIO signals for L298N.

WirelessControl

Bluetooth/WiFi remote control via RPi 5's onboard wireless — replaces Google Sheets polling demo.

## Slide 7

KEY DESIGN DECISIONS

Each choice driven by real classroom constraints

DSI vs I2C Display

I2C HAT required fragile custom framebuffer kernel drivers. DSI is natively supported by RPi firmware — no driver work, higher resolution, better refresh.

✓ DSI

RP2040 vs GPIO Expander IC

A plain MCP23017 expander only gives extra pins. RP2040 adds programmable logic, hardware PWM, MicroPython runtime, and independent field-update capability.

✓ RP2040

SS34B vs 1N4148 Diodes

1N4148 is rated 300mA — undersized for motor flyback. SS34B handles 3A continuous and has faster recovery time appropriate for PWM H-bridge switching.

✓ SS34B Schottky

On-device AI vs Cloud AI

Classroom internet is unreliable. Cloud latency breaks real-time voice interaction. phi3:mini + Vosk + Piper all run on RPi 5 without GPU acceleration.

✓ Fully offline

## Slide 8

BILL OF MATERIALS

Core components — selected for JLCPCB PCBA compatibility

Reference

Part

Description

U1

MCP3008-I/SL

8-ch 10-bit SPI ADC, SOIC-16 narrow

U2

U3

LM2577T-ADJ

L298N

Boost regulator 5V→12V, TO-220-5

Dual H-bridge motor driver, TO-220-15

U4

U5

W25Q64JVXGIQ

RP2040

8MB SPI flash for RP2040, DFN-8

Dual-core Cortex-M0+ co-processor, QFN-56

Y1

12MHz HC-49SMD

Crystal oscillator, 33pF load caps

D1–D9

C33

SS34B

680µF Polymer

3A Schottky, SMA — freewheel & boost diodes

Boost output bulk filter capacitor

J1

2×20 Pin Header

RPi 5 40-pin GPIO extension ribbon

J4, J5

J14

JST-SH 4P (QWIIC)

USB-C 14P

I2C expansion — SparkFun QWIIC ecosystem

RP2040 USB — BOOTSEL firmware flashing

## Slide 9

DEVELOPMENT JOURNEY

Four iterations from concept to fabrication-ready design

Schematic Capture

KiCad Eeschema, component selection (LM2577, MCP3008, SS34B), RP2040 co-processor added for GPIO expansion

01

PCB Layout & DRC

4-layer routing, power trace widths, crystal trace matching, USB D+/D– diff pair, JLCPCB DRC compliance

02

Software Stack

Vosk + Ollama + Piper pipeline on RPi 5 hardware, RP2040 firmware on Pico, motor control validated vs L298N

03

Display & Integration

I2C HAT → DSI migration, RP2040 UART integration, wireless control, AI vision in active development

04

PCB fully routed and validated in KiCad. Software stack running on RPi 5 hardware. Pending: physical JLCPCB fabrication and AI vision integration.

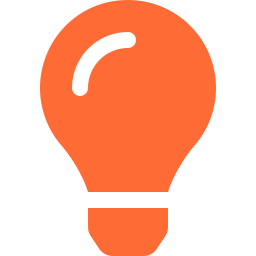
[picture p16: figure]

Current Status

## Slide 10

RESULTS & ACHIEVEMENTS

All primary objectives met — from schematic to running software

4-Layer

Custom PCB

KiCad 9.0, JLCPCB-ready

8MB

SPI Flash

W25Q64 on RP2040

8-CH

Analog ADC

MCP3008 SPI, 10-bit

3.8B

LLM Params

phi3:mini, on-device

Custom 4-layer PCB fully routed in KiCad with JLCPCB DRC compliance

RP2040 co-processor subsystem with UART JSON protocol to RPi 5

Offline AI voice pipeline: Vosk STT → Ollama phi3:mini → Piper TTS

Motor control, 8-channel ADC, QWIIC I2C, and ultrasonic sensing integrated

DFRobot UPS Module enables battery-backed classroom operation

Open hardware and software throughout — KiCad, Debian, MicroPython

## Slide 11

FUTURE DIRECTIONS & LIMITATIONS

What's next and what we know can be improved

Future Directions

AI Vision: Pi Camera + on-device object & plant species classification

Physical JLCPCB fabrication and hardware bring-up testing

INA219 current sense amplifier for higher-accuracy telemetry

Expanded motor voltage flexibility (software-tunable boost output)

Companion app for wireless Bluetooth/WiFi control interface

Known Limitations

Boost output voltage fixed by R1 ratio — not software-adjustable

RP2040 10-bit ADC limits current sensing precision

AI vision subsystem not yet physically integrated

phi3:mini response quality is suitable but not state-of-the-art

## Slide 12

CONCLUSION

Lumio

Open hardware. Embedded AI. Classroom-ready.

Sameed Ahmed • 2VX22CB043 • SonyTech IT Company / VTU Belagavi

KiCad 9.0

Raspberry Pi 5

RP2040

Ollama phi3:mini

JLCPCB PCBA
