BastaMasta/LumioV2_Hardware/(list of files, drawings)

Other design files:
freerouting.dsn
temp-freerouting.dsn
