BastaMasta/LumioV2_Hardware/(commit log)

2026-03-28 deleted autosaves and removed cm5 footprint from pcb
    [LumioV2.kicad_pcb]
2026-03-28 Routed display connector,
    [LumioV2.kicad_sch]
2026-03-28 Routed display connector, added MCP3008 ADC hooked up to spi1 cs2 for analog sensors, and added backup power capacitors to ensure the raspberry pi and the ups module dont die due to sudden surge
    [LumioV2.kicad_sch]
2026-03-30 added all footprints to schematics, also added all footprints to the pcb what's left: layout and routing
    [LumioV2.kicad_pcb, LumioV2.kicad_sch]
2026-03-31 Added rp2040 slave for extra gpios and current and voltage monitor
    [LumioV2.kicad_sch]
2026-04-04 smol changes
    [LumioV2.kicad_sch]
2026-04-04 began routing
    [LumioV2.kicad_pcb, LumioV2.kicad_sch, freerouting.dsn, temp-freerouting.dsn]
2026-04-05 routed abit; replaced the MCP3008 footprint to a 16 pin socket, so that i can swap it easily if the user fries it somehow
    [LumioV2.kicad_pcb, LumioV2.kicad_sch]
2026-04-06 added few more step files
    [LumioV2.kicad_pcb]
2026-04-08 resolved bugs, added documentation, and created filled zone for 3v3 on B.Cu and connected to 3v pins on raspi
    [LumioV2.kicad_pcb]
2026-04-09 Add docs page and generated BOM
2026-04-09 added internship report
    [LumioV2.kicad_pcb]
